harrislab-brown/particle_launcher/Launcher CAD & Fabrication Files/Version 6/For 1.5 mm Spheres/STEP Files/V6_Main-Tube-Section.step

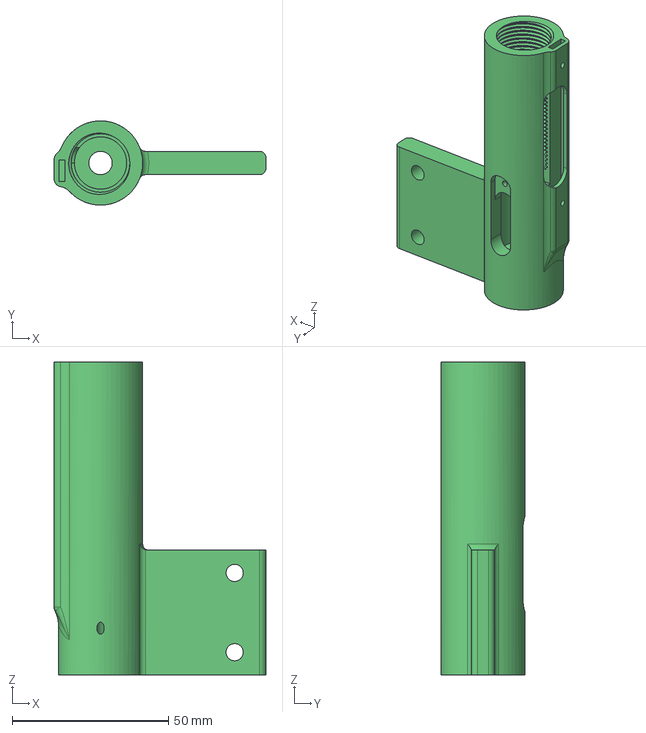
[picture p32: CAD file, 2026-04-17]
Launcher CAD & Fabrication Files/Version 6/For 1.5 mm Spheres/STEP Files/V6_Main-Tube-Section.step
67.8 x 27.0 x 100.3 mm
