harrislab-brown/particle_launcher/Launcher CAD & Fabrication Files/Version 6/For 1.5 mm Spheres/STEP Files/V6_Full-Assembly.step

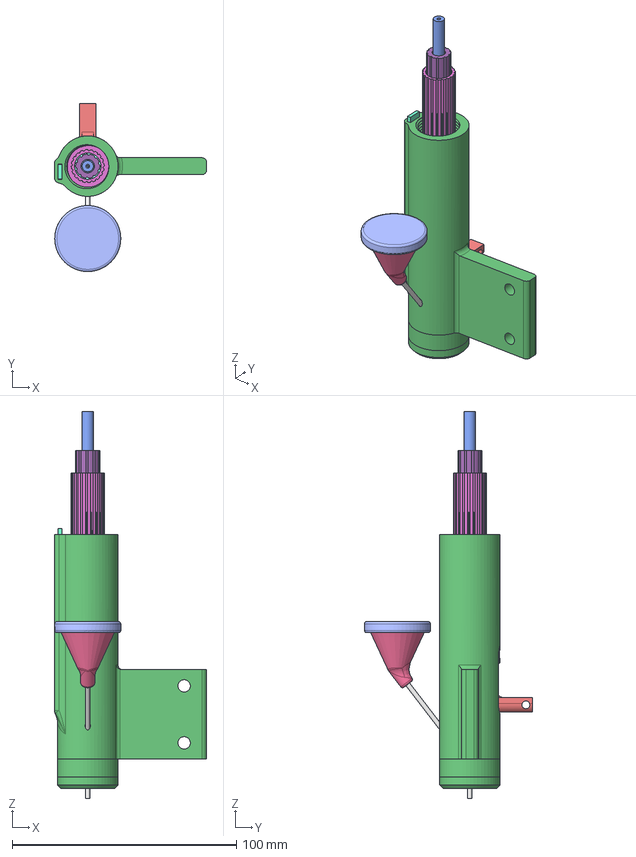
[picture p33: CAD file, 2026-04-17]
Launcher CAD & Fabrication Files/Version 6/For 1.5 mm Spheres/STEP Files/V6_Full-Assembly.step
67.8 x 75.0 x 172.5 mm
Barrel
Particle 1.5mm
Tube
Plunger Tip
Plunger
Latch
Collar
Adjust
Scale
Retainer
Guide
Backstop
Tool
Magazine
Funnel
Funnel Lid
