harrislab-brown/particle_launcher/Launcher CAD & Fabrication Files/Version 6/For 1.5 mm Spheres/3D Printing/PL Hypodermic Needle Cutting Jig.stl

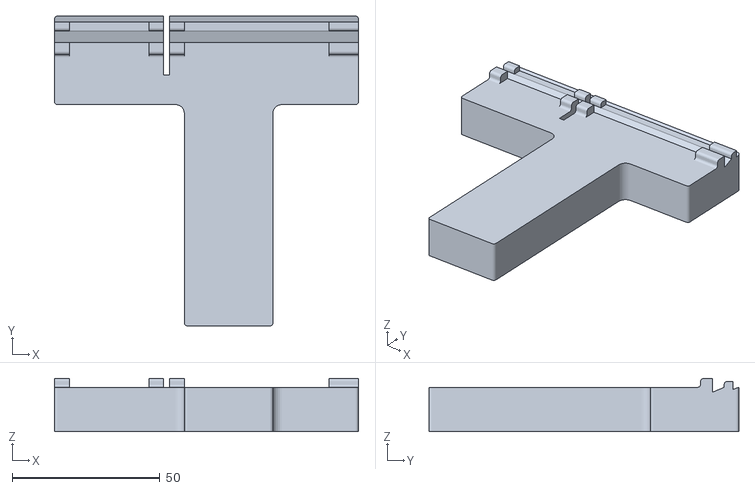
[picture p34: CAD file, 2026-04-17]
Launcher CAD & Fabrication Files/Version 6/For 1.5 mm Spheres/3D Printing/PL Hypodermic Needle Cutting Jig.stl
103.0 x 105.0 x 18.0
