harrislab-brown/particle_launcher/Launcher CAD & Fabrication Files/Version 6/For 1.5 mm Spheres/STEP Files/V6_Plunger-Tip.step

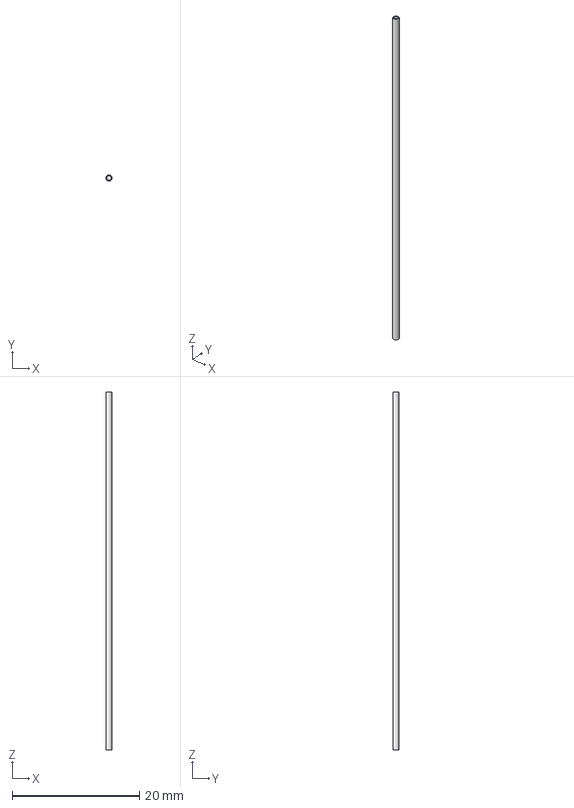
[picture p35: CAD file, 2026-04-17]
Launcher CAD & Fabrication Files/Version 6/For 1.5 mm Spheres/STEP Files/V6_Plunger-Tip.step
0.99 x 0.99 x 56.3 mm
