harrislab-brown/particle_launcher/Launcher CAD & Fabrication Files/Version 6/For 1 mm Spheres/3D Printing/Particle Launcher V6 1mm funnel.stl

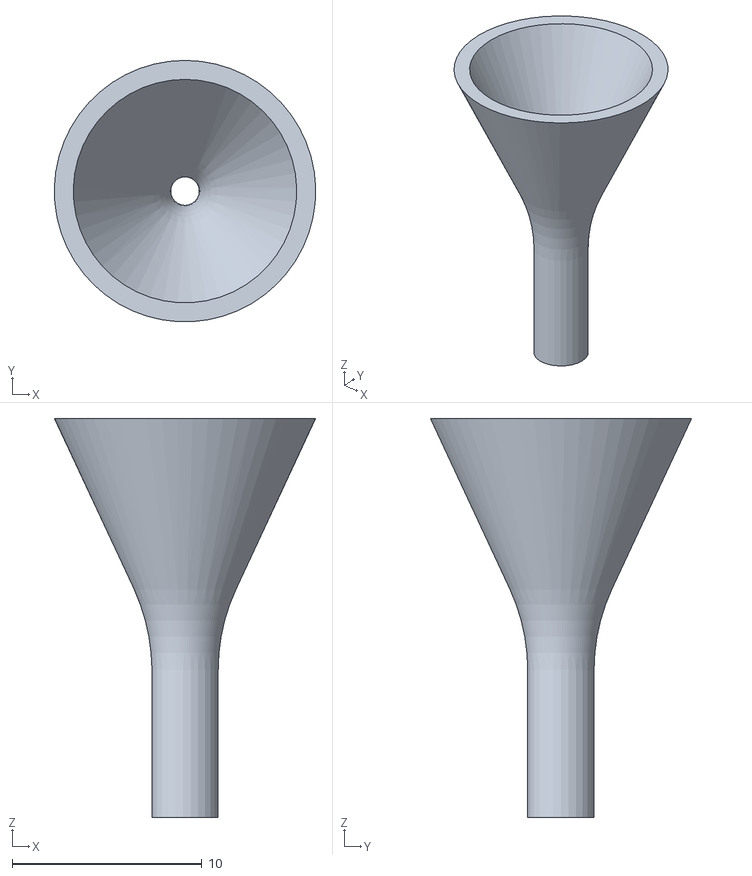
[picture p36: CAD file, 2026-05-19]
Launcher CAD & Fabrication Files/Version 6/For 1 mm Spheres/3D Printing/Particle Launcher V6 1mm funnel.stl
13.8 x 13.7 x 21.0
