harrislab-brown/particle_launcher/Launcher CAD & Fabrication Files/Version 6/For 1.5 mm Spheres/SOLIDWORKS/Tube_2.SLDPRT

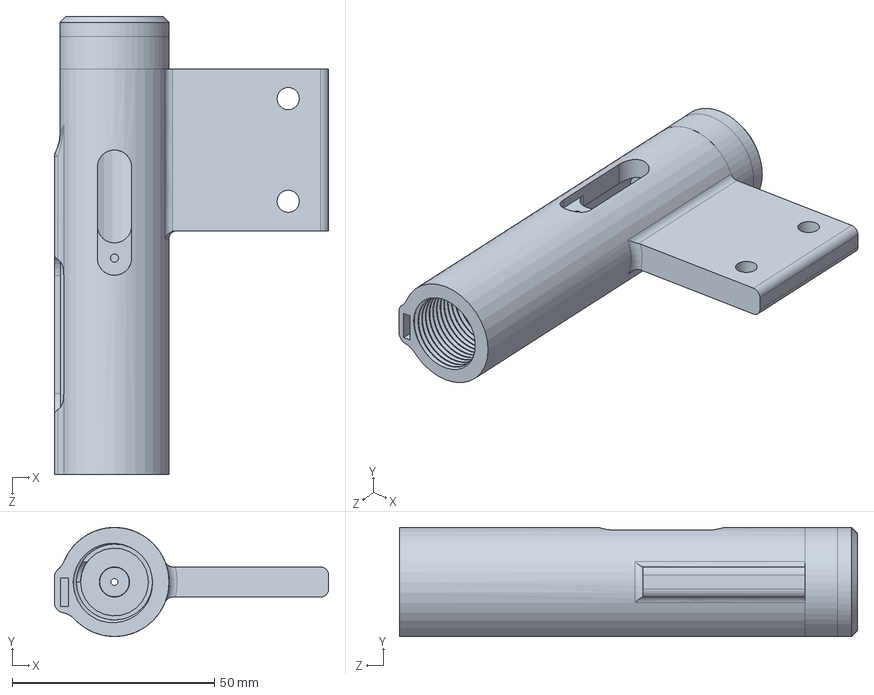
[picture p38: CAD file, 2026-04-17]
Launcher CAD & Fabrication Files/Version 6/For 1.5 mm Spheres/SOLIDWORKS/Tube_2.SLDPRT
67.8 x 27.0 x 113.3 mm
