harrislab-brown/particle_launcher/Launcher CAD & Fabrication Files/Version 6/For 1.5 mm Spheres/STEP Files/V6_Backstop-Tool.step

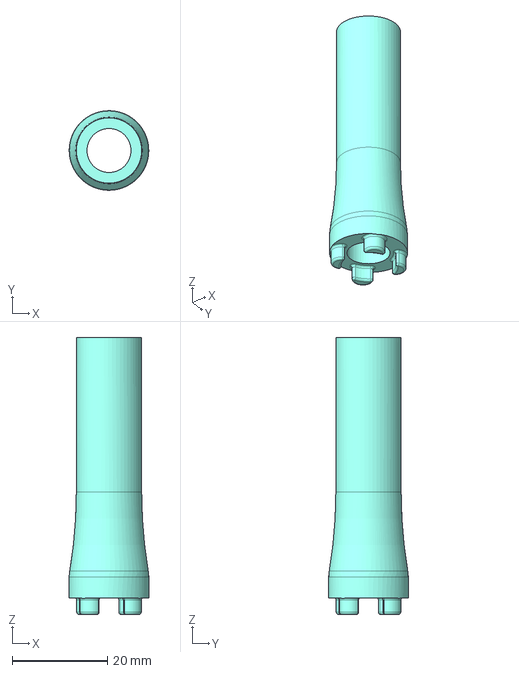
[picture p39: CAD file, 2026-04-17]
Launcher CAD & Fabrication Files/Version 6/For 1.5 mm Spheres/STEP Files/V6_Backstop-Tool.step
16.7 x 16.7 x 58.3 mm
