harrislab-brown/particle_launcher/Launcher CAD & Fabrication Files/Version 6/For 1 mm Spheres/3D Printing/Particle Launcher V6 1mm magazine.stl

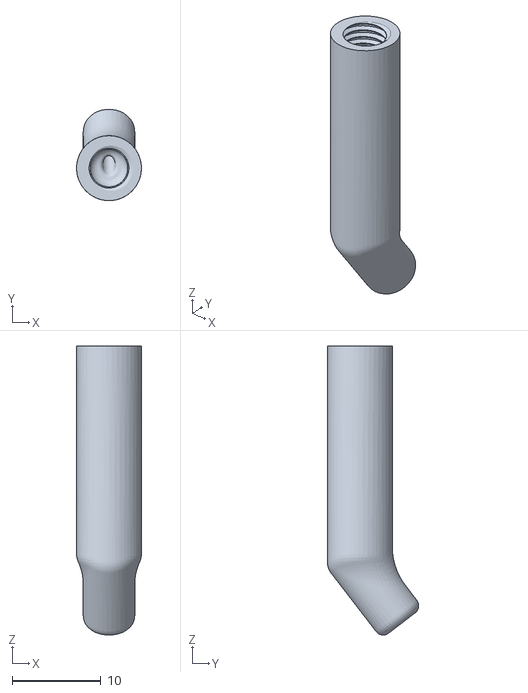
[picture p40: CAD file, 2026-05-19]
Launcher CAD & Fabrication Files/Version 6/For 1 mm Spheres/3D Printing/Particle Launcher V6 1mm magazine.stl
7.31 x 10.3 x 32.5
