harrislab-brown/particle_launcher/Launcher CAD & Fabrication Files/Version 6/For 1.5 mm Spheres/3D Printing/PL Hypodermic Needle Hole Sizer.stl

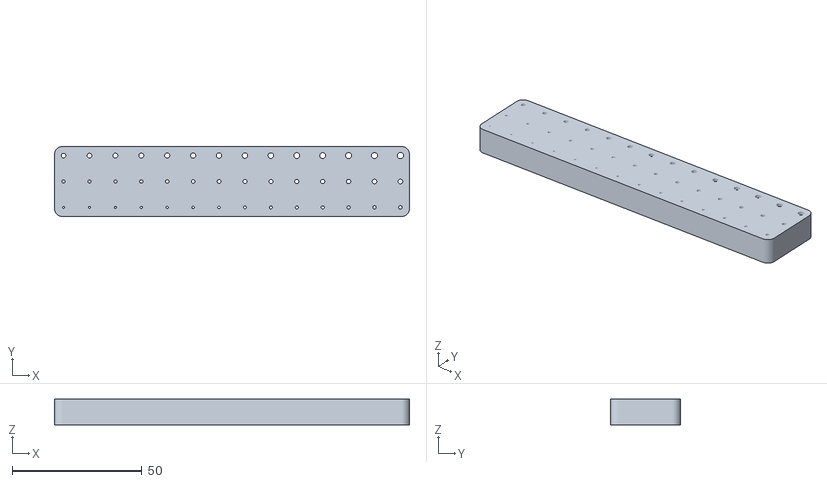
[picture p41: CAD file, 2026-04-17]
Launcher CAD & Fabrication Files/Version 6/For 1.5 mm Spheres/3D Printing/PL Hypodermic Needle Hole Sizer.stl
137.0 x 27.0 x 10.0
