harrislab-brown/particle_launcher/Launcher CAD & Fabrication Files/Version 6/For 1.5 mm Spheres/STEP Files/V6_Retainer.step

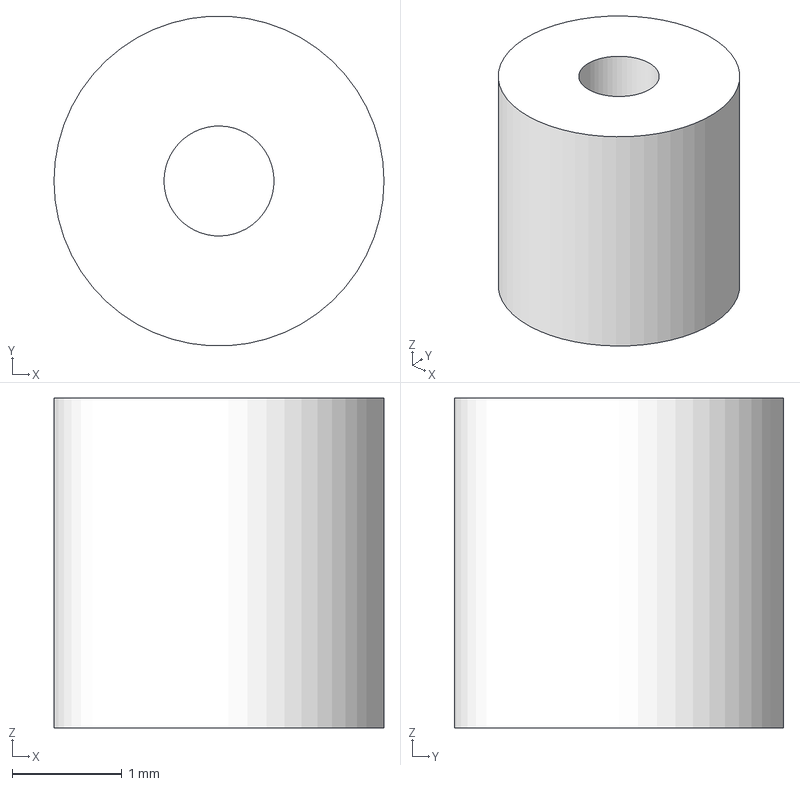
[picture p42: CAD file, 2026-04-17]
Launcher CAD & Fabrication Files/Version 6/For 1.5 mm Spheres/STEP Files/V6_Retainer.step
3.00 x 2.99 x 3.00 mm
