harrislab-brown/particle_launcher/Launcher CAD & Fabrication Files/Version 6/For 1 mm Spheres/3D Printing/Particle Launcher V6 1mm lid.stl

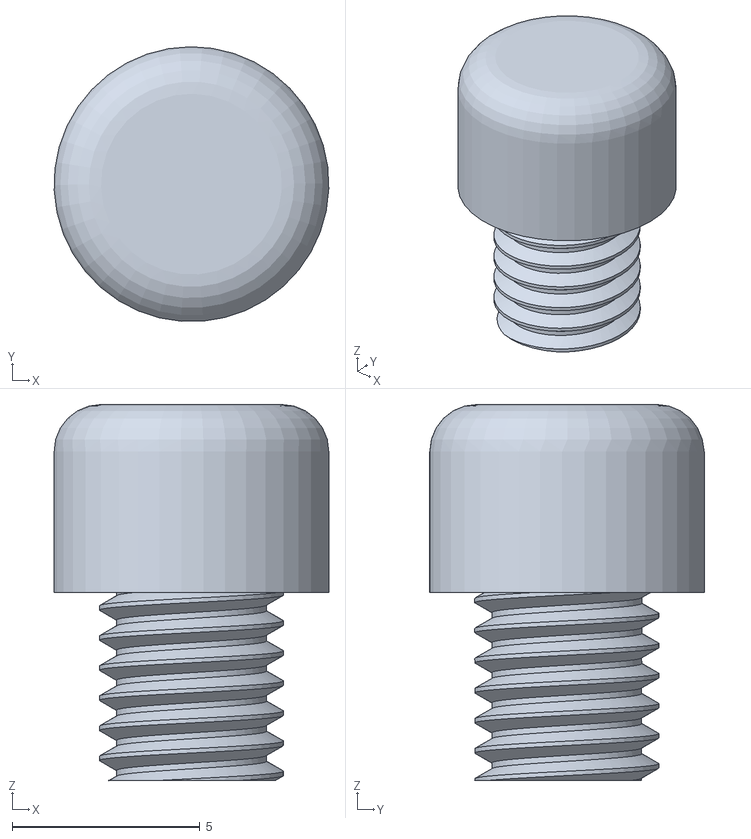
[picture p43: CAD file, 2026-05-19]
Launcher CAD & Fabrication Files/Version 6/For 1 mm Spheres/3D Printing/Particle Launcher V6 1mm lid.stl
7.30 x 7.30 x 10.0
