harrislab-brown/particle_launcher/Launcher CAD & Fabrication Files/Version 6/For 1 mm Spheres/3D Printing/Particle Launcher V6 1mm latch.stl

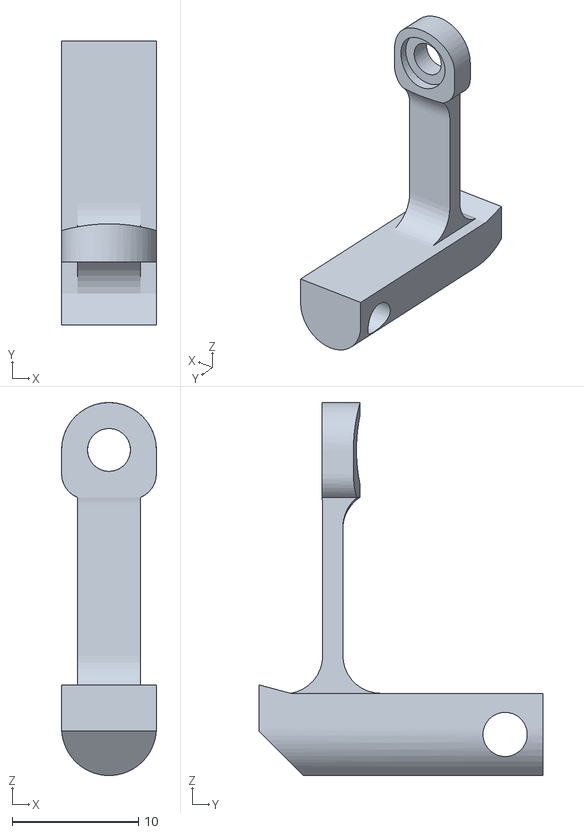
[picture p45: CAD file, 2026-05-19]
Launcher CAD & Fabrication Files/Version 6/For 1 mm Spheres/3D Printing/Particle Launcher V6 1mm latch.stl
7.50 x 22.5 x 29.5
