harrislab-brown/particle_launcher/Launcher CAD & Fabrication Files/Version 6/For 1.5 mm Spheres/3D Printing/Particle Launcher V6 plunger.stl

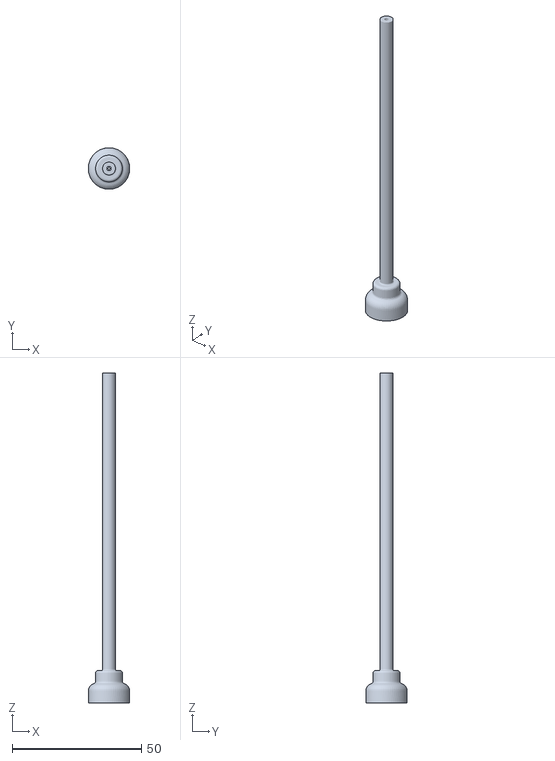
[picture p46: CAD file, 2026-04-17]
Launcher CAD & Fabrication Files/Version 6/For 1.5 mm Spheres/3D Printing/Particle Launcher V6 plunger.stl
16.0 x 16.0 x 127.5
