harrislab-brown/particle_launcher/Launcher CAD & Fabrication Files/Version 6/For 1 mm Spheres/3D Printing/Particle Launcher V6 1mm backstop.stl

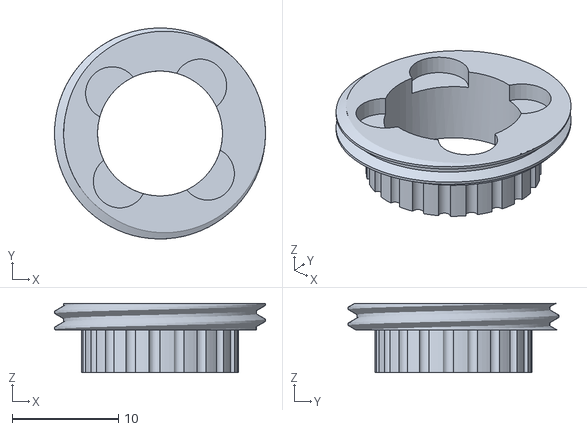
[picture p48: CAD file, 2026-05-19]
Launcher CAD & Fabrication Files/Version 6/For 1 mm Spheres/3D Printing/Particle Launcher V6 1mm backstop.stl
19.8 x 19.8 x 6.50
