harrislab-brown/particle_launcher/Launcher CAD & Fabrication Files/Version 6/For 1.5 mm Spheres/3D Printing/Particle Launcher V6 funnel.stl

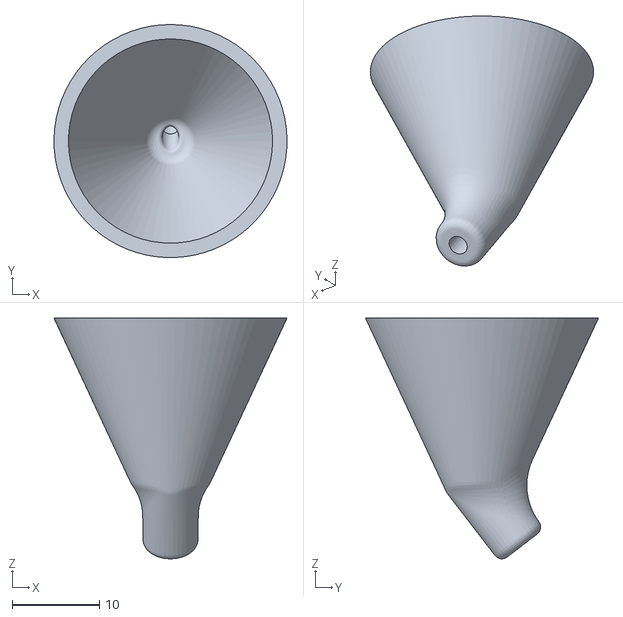
[picture p49: CAD file, 2026-04-17]
Launcher CAD & Fabrication Files/Version 6/For 1.5 mm Spheres/3D Printing/Particle Launcher V6 funnel.stl
26.7 x 26.6 x 27.5
