harrislab-brown/particle_launcher/Launcher CAD & Fabrication Files/Version 6/For 1.5 mm Spheres/3D Printing/Particle Launcher V6 funnel lid.stl

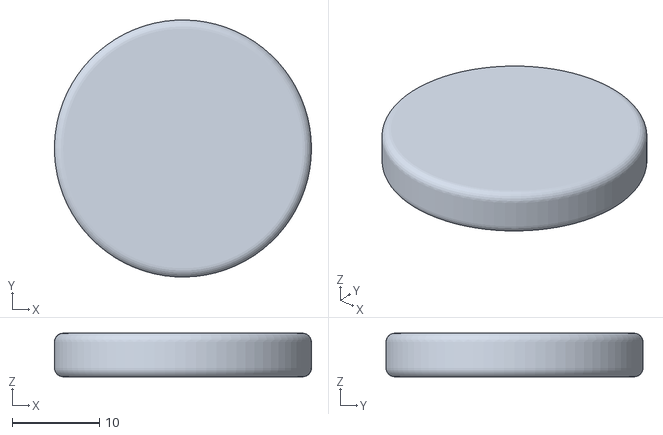
[picture p53: CAD file, 2026-04-17]
Launcher CAD & Fabrication Files/Version 6/For 1.5 mm Spheres/3D Printing/Particle Launcher V6 funnel lid.stl
29.4 x 29.5 x 5.00
