harrislab-brown/particle_launcher/Launcher CAD & Fabrication Files/Version 6/For 1.5 mm Spheres/SOLIDWORKS/Particle-Launcher-V6.SLDASM

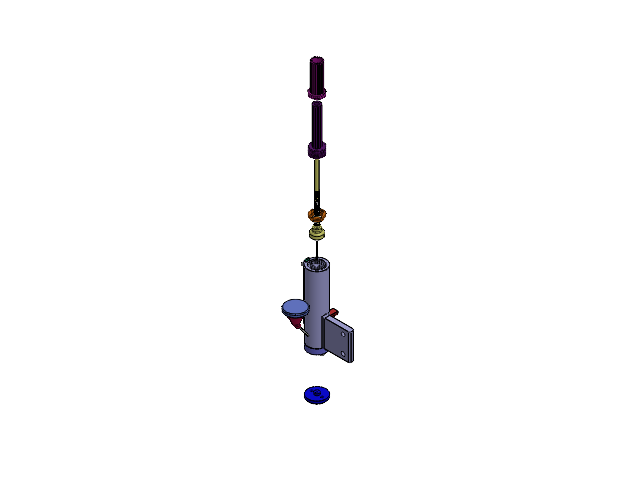
[picture p60: CAD file, 2026-04-17]
Launcher CAD & Fabrication Files/Version 6/For 1.5 mm Spheres/SOLIDWORKS/Particle-Launcher-V6.SLDASM
V6_Main-Tube-Section
V6_Middle-Tube-Section
V6_End-Tube-Section
V6_Adjust
V6_Backstop
V6_Barrel
V6_Collar
V6_Guide
V6_Latch
V6_Magazine
V6_Plunger-Tip
V6_Plunger
V6_Retainer
V6_Scale
V6_Funnel
V6_Funnel Lid
9657K42_Compression Spring
91292A015_18-8 Stainless Steel Socket Head Screw x 3
94459A140_Heat-Set Inserts for Plastic x 2
91292A115_18-8 Stainless Steel Socket Head Screw x 2
