harrislab-brown/particle_launcher/(list of files, cad)

Other CAD files:
Launcher CAD & Fabrication Files/Version 6/For 1 mm Spheres/3D Printing/PLV6_1mm_BAMBULABX1C.gcode.3mf
Launcher CAD & Fabrication Files/Version 6/For 1.5 mm Spheres/3D Printing/PLV6_1.5mm_BAMBULABX1C.gcode.3mf
Launcher CAD & Fabrication Files/Version 6/For 1.5 mm Spheres/SOLIDWORKS/Tool.SLDPRT
Launcher CAD & Fabrication Files/Version 6/For 1.5 mm Spheres/SOLIDWORKS/Particle 1.5mm.SLDPRT
Launcher CAD & Fabrication Files/Version 6/For 1.5 mm Spheres/STEP Files/V6_Plunger.step
Launcher CAD & Fabrication Files/Version 6/For 1.5 mm Spheres/3D Printing/Particle Launcher V6 backstop.stl
Launcher CAD & Fabrication Files/Version 6/For 1.5 mm Spheres/STEP Files/V6_Backstop.step
Launcher CAD & Fabrication Files/Version 6/For 1 mm Spheres/3D Printing/Particle Launcher V6 1mm tube.stl
Launcher CAD & Fabrication Files/Version 6/For 1.5 mm Spheres/3D Printing/Particle Launcher V6 latch.stl
Launcher CAD & Fabrication Files/Version 6/For 1.5 mm Spheres/3D Printing/Particle Launcher V6 tube.stl
Launcher CAD & Fabrication Files/Version 6/For 1.5 mm Spheres/STEP Files/V6_Funnel-Lid.step
Launcher CAD & Fabrication Files/Version 6/For 1.5 mm Spheres/3D Printing/Particle Launcher V6 tool.stl
Launcher CAD & Fabrication Files/Version 6/For 1 mm Spheres/3D Printing/Particle Launcher V6 1mm adjust.stl
Launcher CAD & Fabrication Files/Version 6/For 1.5 mm Spheres/3D Printing/Particle Launcher V6 middle.stl
Launcher CAD & Fabrication Files/Version 6/For 1.5 mm Spheres/3D Printing/Particle Launcher V6 end.stl
Launcher CAD & Fabrication Files/Version 6/For 1.5 mm Spheres/STEP Files/V6_Funnel.step
Launcher CAD & Fabrication Files/Version 6/For 1.5 mm Spheres/3D Printing/Particle Launcher V6 adjust.stl
Launcher CAD & Fabrication Files/Version 6/For 1.5 mm Spheres/STEP Files/V6_End-Tube-Section.step
Launcher CAD & Fabrication Files/Version 6/For 1.5 mm Spheres/3D Printing/Particle Launcher V6 collar.stl
Launcher CAD & Fabrication Files/Version 6/For 1.5 mm Spheres/STEP Files/V6_Collar.step
Launcher CAD & Fabrication Files/Version 6/For 1.5 mm Spheres/STEP Files/V6_Middle-Tube-Section.step
Launcher CAD & Fabrication Files/Tooling/PL Flex Tube Hole Sizer.f3d
Launcher CAD & Fabrication Files/Tooling/PL Hypodermic Needle Cutting Jig.f3d
Launcher CAD & Fabrication Files/Tooling/PL Hypodermic Needle Hole Sizer.f3d
Launcher CAD & Fabrication Files/Tooling/PL Mirror Bracket.f3d
Launcher CAD & Fabrication Files/Version 6/For 1 mm Spheres/Fusion/Particle Launcher V6 1mm.f3d
Launcher CAD & Fabrication Files/Version 6/For 1.5 mm Spheres/Fusion/Particle Launcher V6.f3d
Launcher CAD & Fabrication Files/Version 6/For 1.5 mm Spheres/SOLIDWORKS/91292A015_18-8 Stainless Steel Socket Head Screw.SLDPRT
Launcher CAD & Fabrication Files/Version 6/For 1.5 mm Spheres/SOLIDWORKS/91292A115_18-8 Stainless Steel Socket Head Screw.SLDPRT
Launcher CAD & Fabrication Files/Version 6/For 1.5 mm Spheres/SOLIDWORKS/94459A140_Heat-Set Inserts for Plastic.SLDPRT
Launcher CAD & Fabrication Files/Version 6/For 1.5 mm Spheres/SOLIDWORKS/9657K42_Compression Spring.SLDPRT
Launcher CAD & Fabrication Files/Version 6/For 1.5 mm Spheres/SOLIDWORKS/Drawings/Particle-Launcher-V6.SLDDRW
Launcher CAD & Fabrication Files/Version 6/For 1.5 mm Spheres/SOLIDWORKS/Drawings/V6_Adjust.SLDDRW
Launcher CAD & Fabrication Files/Version 6/For 1.5 mm Spheres/SOLIDWORKS/Drawings/V6_Backstop.SLDDRW
Launcher CAD & Fabrication Files/Version 6/For 1.5 mm Spheres/SOLIDWORKS/Drawings/V6_Barrel.SLDDRW
Launcher CAD & Fabrication Files/Version 6/For 1.5 mm Spheres/SOLIDWORKS/Drawings/V6_Collar.SLDDRW
Launcher CAD & Fabrication Files/Version 6/For 1.5 mm Spheres/SOLIDWORKS/Drawings/V6_End-Tube-Section.SLDDRW
Launcher CAD & Fabrication Files/Version 6/For 1.5 mm Spheres/SOLIDWORKS/Drawings/V6_Funnel Lid.SLDDRW
Launcher CAD & Fabrication Files/Version 6/For 1.5 mm Spheres/SOLIDWORKS/Drawings/V6_Funnel.SLDDRW
Launcher CAD & Fabrication Files/Version 6/For 1.5 mm Spheres/SOLIDWORKS/Drawings/V6_Guide.SLDDRW
Launcher CAD & Fabrication Files/Version 6/For 1.5 mm Spheres/SOLIDWORKS/Drawings/V6_Latch.SLDDRW
Launcher CAD & Fabrication Files/Version 6/For 1.5 mm Spheres/SOLIDWORKS/Drawings/V6_Magazine.SLDDRW
Launcher CAD & Fabrication Files/Version 6/For 1.5 mm Spheres/SOLIDWORKS/Drawings/V6_Main-Tube-Section.SLDDRW
Launcher CAD & Fabrication Files/Version 6/For 1.5 mm Spheres/SOLIDWORKS/Drawings/V6_Middle-Tube-Section.SLDDRW
Launcher CAD & Fabrication Files/Version 6/For 1.5 mm Spheres/SOLIDWORKS/Drawings/V6_Plunger-Tip.SLDDRW
Launcher CAD & Fabrication Files/Version 6/For 1.5 mm Spheres/SOLIDWORKS/Drawings/V6_Plunger.SLDDRW
Launcher CAD & Fabrication Files/Version 6/For 1.5 mm Spheres/SOLIDWORKS/Drawings/V6_Retainer.SLDDRW
Launcher CAD & Fabrication Files/Version 6/For 1.5 mm Spheres/SOLIDWORKS/Drawings/V6_Scale.SLDDRW
Launcher CAD & Fabrication Files/Version 6/For 1.5 mm Spheres/SOLIDWORKS/V6_Adjust.SLDPRT
Launcher CAD & Fabrication Files/Version 6/For 1.5 mm Spheres/SOLIDWORKS/V6_Backstop.SLDPRT
Launcher CAD & Fabrication Files/Version 6/For 1.5 mm Spheres/SOLIDWORKS/V6_Barrel.SLDPRT
Launcher CAD & Fabrication Files/Version 6/For 1.5 mm Spheres/SOLIDWORKS/V6_Collar.SLDPRT
Launcher CAD & Fabrication Files/Version 6/For 1.5 mm Spheres/SOLIDWORKS/V6_End-Tube-Section.SLDPRT
Launcher CAD & Fabrication Files/Version 6/For 1.5 mm Spheres/SOLIDWORKS/V6_Full-Assembly(2).SLDASM
Launcher CAD & Fabrication Files/Version 6/For 1.5 mm Spheres/SOLIDWORKS/V6_Full-Assembly.SLDASM
Launcher CAD & Fabrication Files/Version 6/For 1.5 mm Spheres/SOLIDWORKS/V6_Funnel Lid.SLDPRT
Launcher CAD & Fabrication Files/Version 6/For 1.5 mm Spheres/SOLIDWORKS/V6_Funnel.SLDPRT
Launcher CAD & Fabrication Files/Version 6/For 1.5 mm Spheres/SOLIDWORKS/V6_Guide.SLDPRT
Launcher CAD & Fabrication Files/Version 6/For 1.5 mm Spheres/SOLIDWORKS/V6_Latch.SLDPRT
Launcher CAD & Fabrication Files/Version 6/For 1.5 mm Spheres/SOLIDWORKS/V6_Magazine.SLDPRT
Launcher CAD & Fabrication Files/Version 6/For 1.5 mm Spheres/SOLIDWORKS/V6_Main-Tube-Section.SLDPRT
Launcher CAD & Fabrication Files/Version 6/For 1.5 mm Spheres/SOLIDWORKS/V6_Middle-Tube-Section.SLDPRT
Launcher CAD & Fabrication Files/Version 6/For 1.5 mm Spheres/SOLIDWORKS/V6_Plunger-Tip.SLDPRT
Launcher CAD & Fabrication Files/Version 6/For 1.5 mm Spheres/SOLIDWORKS/V6_Plunger.SLDPRT
Launcher CAD & Fabrication Files/Version 6/For 1.5 mm Spheres/SOLIDWORKS/V6_Retainer.SLDPRT
Launcher CAD & Fabrication Files/Version 6/For 1.5 mm Spheres/SOLIDWORKS/V6_Scale.SLDPRT
Launcher CAD & Fabrication Files/Versions 1-5/Particle Launcher V1.f3d
Launcher CAD & Fabrication Files/Versions 1-5/Particle Launcher V2-V3.f3d
Launcher CAD & Fabrication Files/Versions 1-5/Particle Launcher V4.f3d
Launcher CAD & Fabrication Files/Versions 1-5/Particle Launcher V5.5 1mm.f3d
Launcher CAD & Fabrication Files/Versions 1-5/Particle Launcher V5.f3d
