harrislab-brown/particle_launcher/Launcher CAD & Fabrication Files/Version 6/For 1.5 mm Spheres/SOLIDWORKS/AssemPic.png

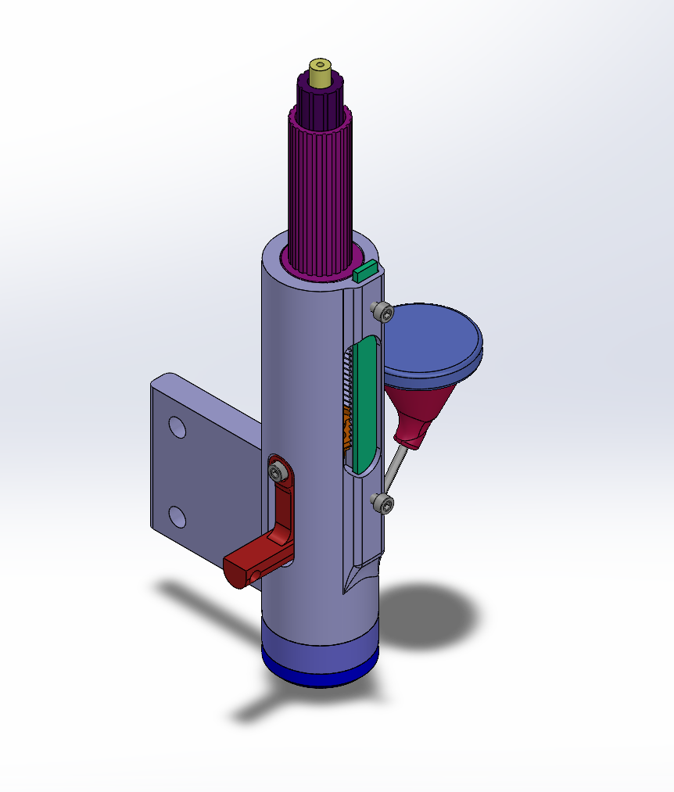
Launcher CAD & Fabrication Files/Version 6/For 1.5 mm Spheres/SOLIDWORKS/AssemPic.png
