harrislab-brown/particle_launcher/Launcher CAD & Fabrication Files/Version 6/For 1.5 mm Spheres/SOLIDWORKS/Drawings/Particle-Launcher-V6_sheet2 copy.PNG

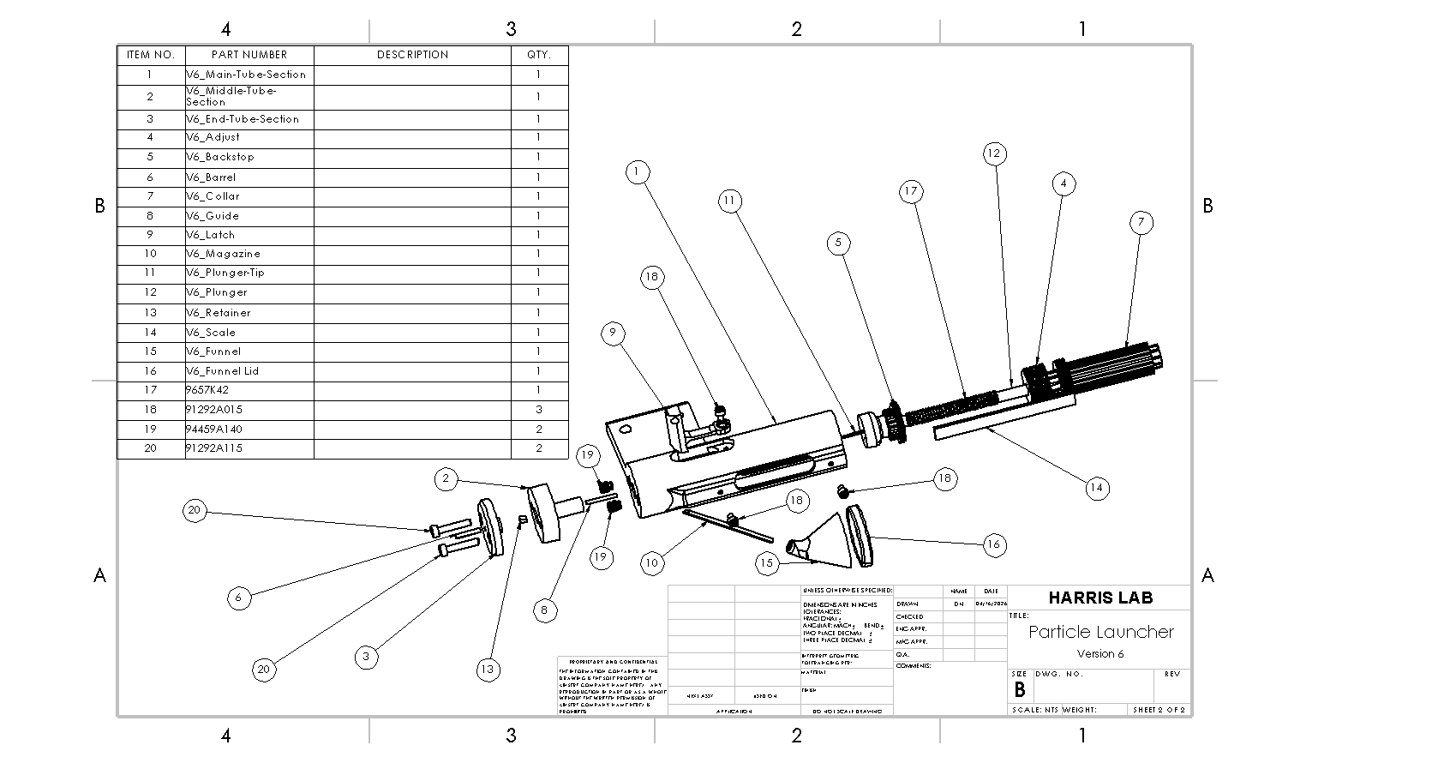
Launcher CAD & Fabrication Files/Version 6/For 1.5 mm Spheres/SOLIDWORKS/Drawings/Particle-Launcher-V6_sheet2 copy.PNG
