harrislab-brown/particle_launcher/sphere_tracking/scrapped sphere tracking/sphere_results.csv

-0.00017446992997189 | -0.0316304365709858 | 1.12473963070912e-05
-0.00017957161328979 | -0.0308132365032768 | 1.3789979136524e-05
-0.000184409683682624 | -0.0291788363678586 | 1.62013040457478e-05
-0.00018898414115039 | -0.0275444362324403 | 1.84813710347628e-05
-0.000193294985693089 | -0.0259100360970219 | 2.0630180103569e-05
-0.00019734221731072 | -0.0242756359616035 | 2.26477312521662e-05
-0.000201125836003283 | -0.0226412358261853 | 2.45340244805545e-05
-0.000204645841770779 | -0.021006835690767 | 2.6289059788734e-05
-0.000207902234613208 | -0.0193724355553486 | 2.79128371767046e-05
-0.000210895014530569 | -0.0177380354199302 | 2.94053566444664e-05
-0.000213624181522863 | -0.0161036352845119 | 3.07666181920192e-05
-0.000216089735590089 | -0.0144692351490935 | 3.19966218193632e-05
-0.000218291676732248 | -0.0128348350136753 | 3.30953675264983e-05
-0.000220230004949339 | -0.011200434878257 | 3.40628553134245e-05
-0.000221904720241363 | -0.00956603474283858 | 3.48990851801418e-05
-0.00022331582260832 | 0.00346403497770069 | 3.56040571266503e-05
-0.000220787289603395 | 0.0113501783301554 | 3.547947402811e-05
-0.000219654474759882 | 0.00336657978489084 | 3.52771973243086e-05
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
