harrislab-brown/particle_launcher/Launcher CAD & Fabrication Files/Version 6/For 1.5 mm Spheres/SOLIDWORKS/Drawings/Particle-Launcher-V6.pdf

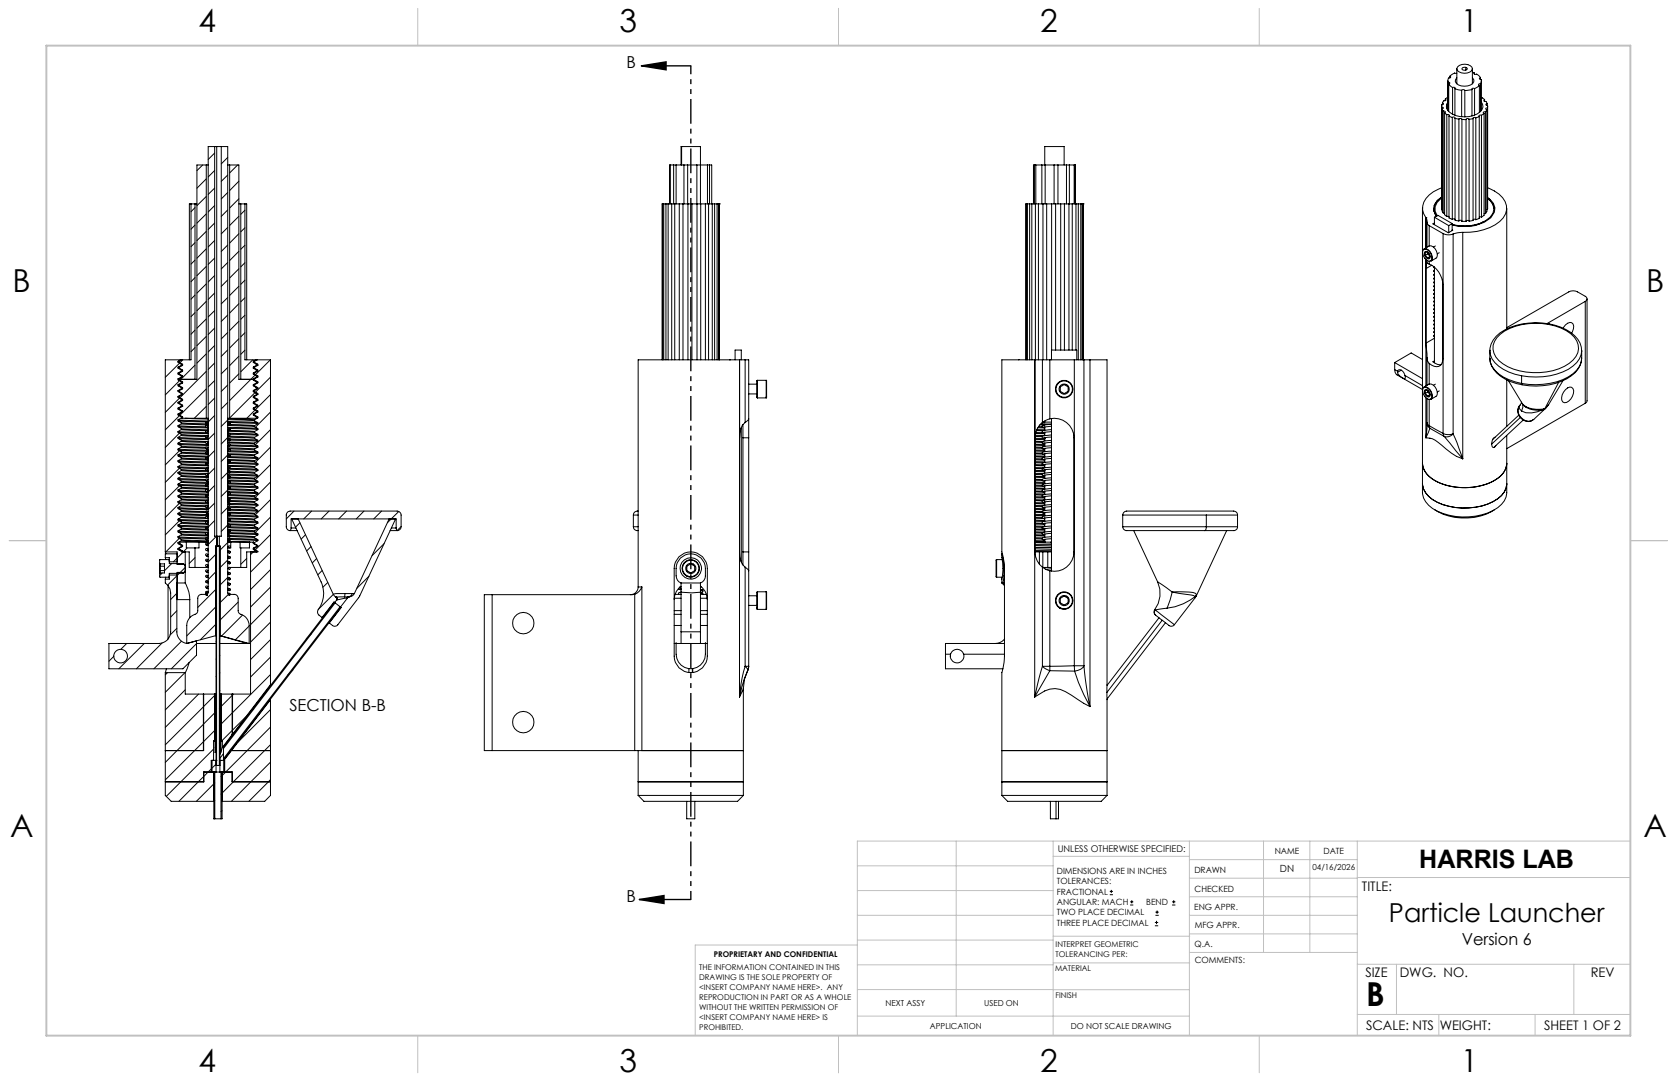
[picture p81: page 1]
SECTION B-B

UNLESS OTHERWISE SPECIFIED: | | | DATE | HARRIS LAB NAME
DIMENSIONS ARE IN INCHES TOLERANCES: FRACTIONAL ANGULAR: MACH BEND TWO PLACE DECIMAL THREE PLACE DECIMAL | DRAWN | DN | 04/16/2026

CHECKED | | | TITLE: Particle Launcher Version 6

ENG APPR.
MFG APPR.

INTERPRET GEOMETRIC TOLERANCING PER: | Q.A.
MATERIAL | | SIZE B | DWG. NO. | REV

PROPRIETARY AND CONFIDENTIAL
THE INFORMATION CONTAINED IN THIS
DRAWING IS THE SOLE PROPERTY OF
<INSERT COMPANY NAME HERE>. ANY
REPRODUCTION IN PART OR AS A WHOLE
WITHOUT THE WRITTEN PERMISSION OF
<INSERT COMPANY NAME HERE> IS
PROHIBITED.

NEXT ASSY | USED ON | FINISH

APPLICATION | DO NOT SCALE DRAWING | | SCALE: NTS | WEIGHT: | SHEET 1 OF 2

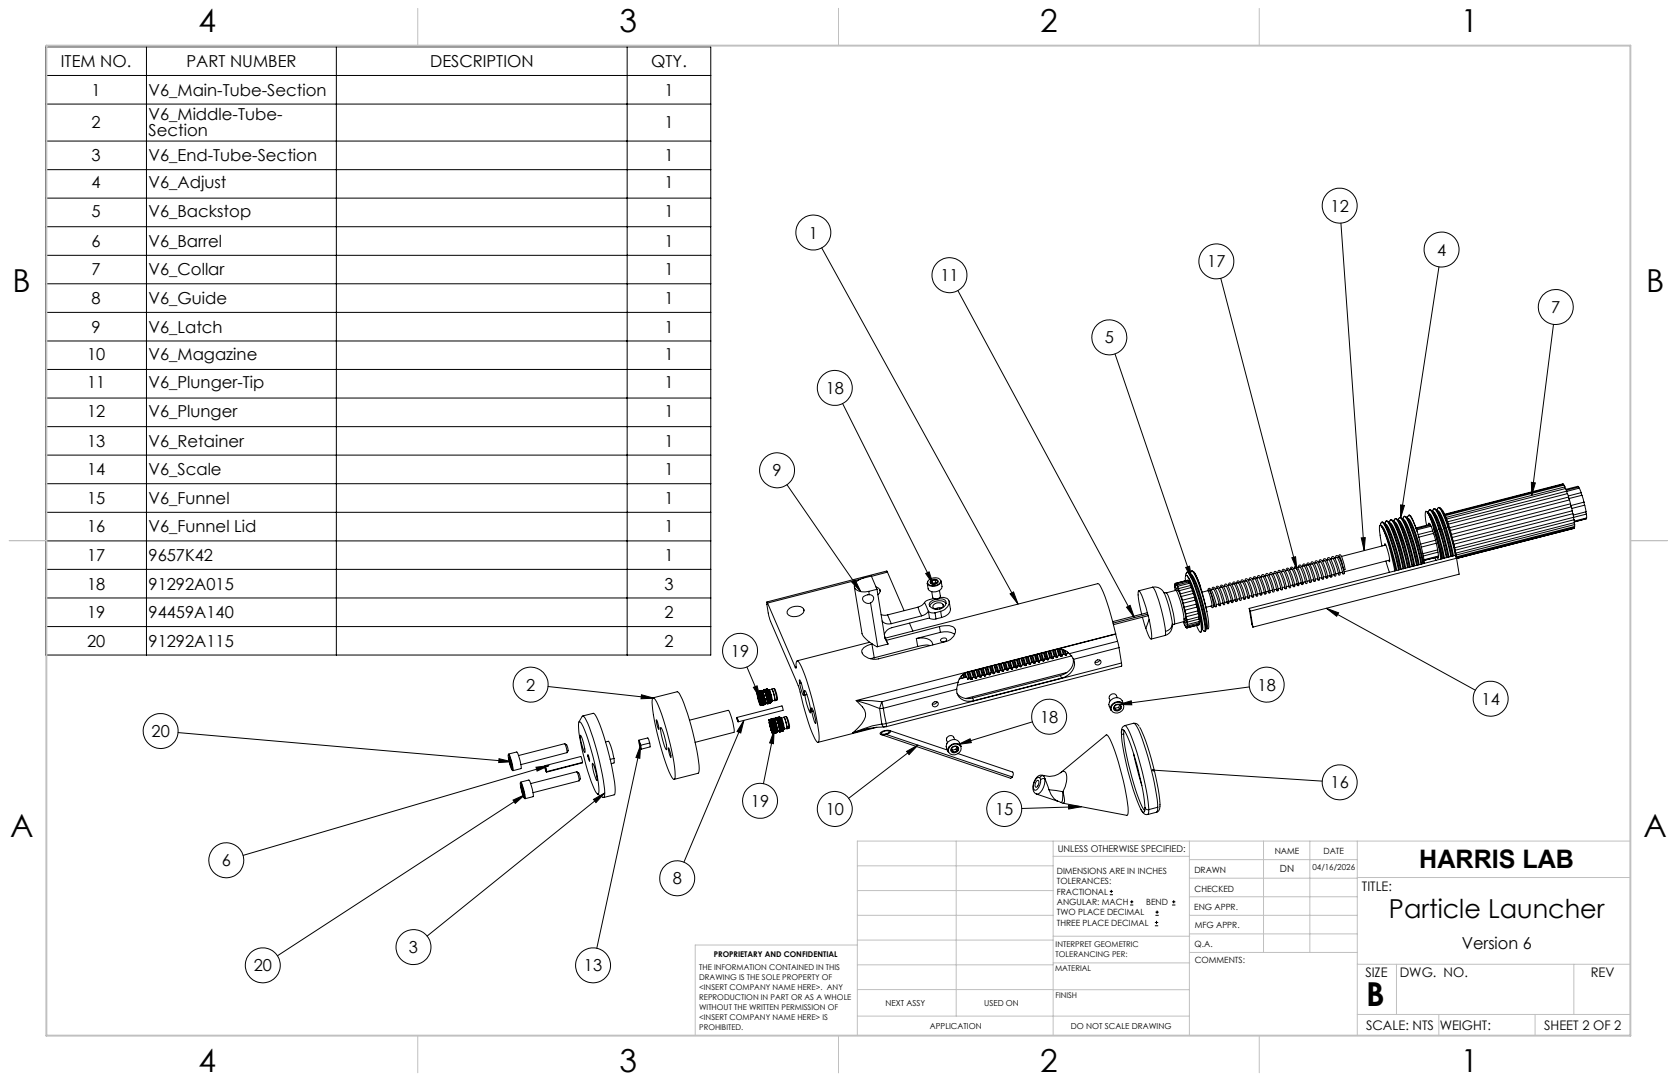
[picture p82: page 2]

ITEM NO. | PART NUMBER | DESCRIPTION | QTY.
1 | V6_Main-Tube-Section | | 1
2 | V6_Middle-Tube-Section | | 1
3 | V6_End-Tube-Section | | 1
4 | V6_Adjust | | 1
5 | V6_Backstop | | 1
6 | V6_Barrel | | 1
7 | V6_Collar | | 1
8 | V6_Guide | | 1
9 | V6_Latch | | 1
10 | V6_Magazine | | 1
11 | V6_Plunger-Tip | | 1
12 | V6_Plunger | | 1
13 | V6_Retainer | | 1
14 | V6_Scale | | 1
15 | V6_Funnel | | 1
16 17 | V6_Funnel Lid 9657K42 | | 1 1

18 | 91292A015 | | 3
19 | 94459A140 | | 2
20 | 91292A115 | | 2

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

CHECKED | | | TITLE: Particle Launcher Version 6

ENG APPR.
MFG APPR.

INTERPRET GEOMETRIC TOLERANCING PER: | Q.A.
MATERIAL | | SIZE B | DWG. NO. | REV

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

NEXT ASSY | USED ON | FINISH

APPLICATION | DO NOT SCALE DRAWING | | SCALE: NTS | WEIGHT: | SHEET 2 OF 2
