harrislab-brown/particle_launcher/Launcher CAD & Fabrication Files/Version 6/For 1.5 mm Spheres/SOLIDWORKS/Drawings/V6_Adjust.pdf

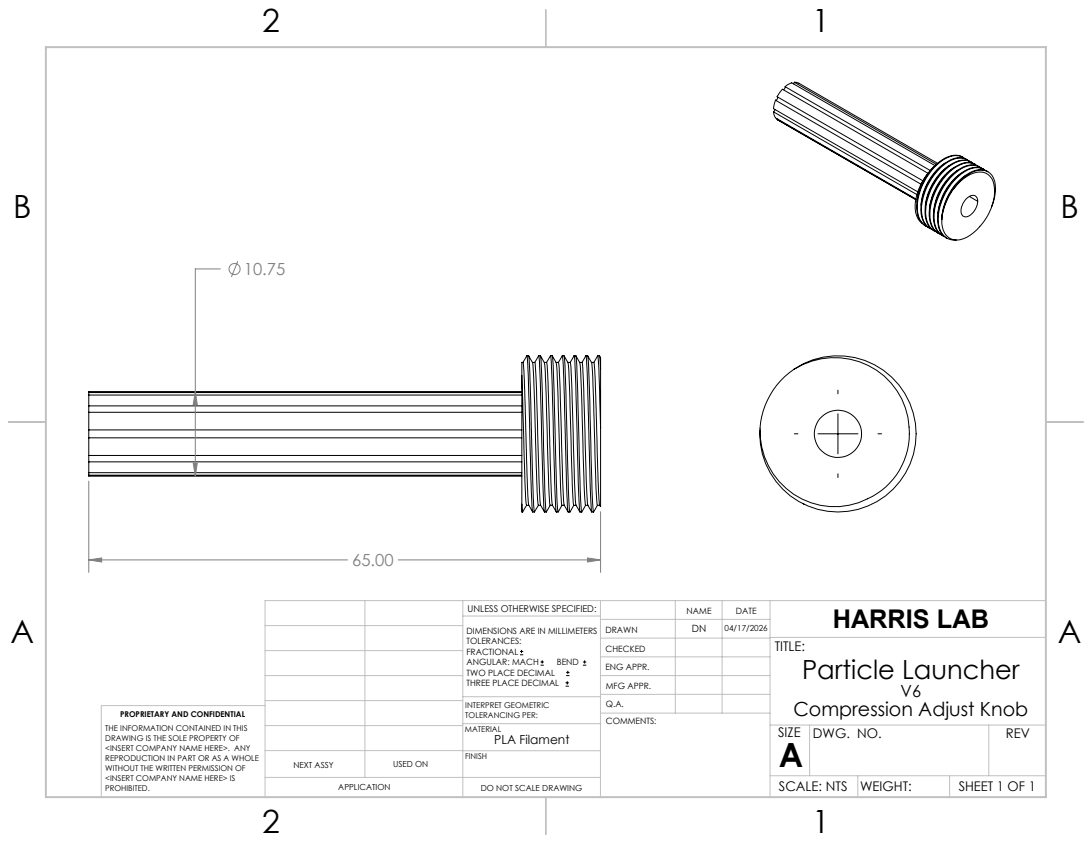
[picture p83: page 1]

UNLESS OTHERWISE SPECIFIED: | | | DATE | HARRIS LAB NAME

DIMENSIONS ARE IN MILLIMETERS TOLERANCES: FRACTIONAL ANGULAR: MACH BEND TWO PLACE DECIMAL THREE PLACE DECIMAL | DRAWN | DN | 04/17/2026

CHECKED | | | TITLE: Particle Launcher V6 Compression Adjust Knob

ENG APPR.
MFG APPR.

INTERPRET GEOMETRIC TOLERANCING PER: | Q.A.
MATERIAL PLA Filament | | SIZE A | DWG. NO. | REV

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

NEXT ASSY | USED ON | FINISH

APPLICATION | DO NOT SCALE DRAWING | | SCALE: NTS | WEIGHT: | SHEET 1 OF 1
