harrislab-brown/particle_launcher/Launcher CAD & Fabrication Files/Version 6/For 1.5 mm Spheres/SOLIDWORKS/Drawings/V6_Guide.pdf

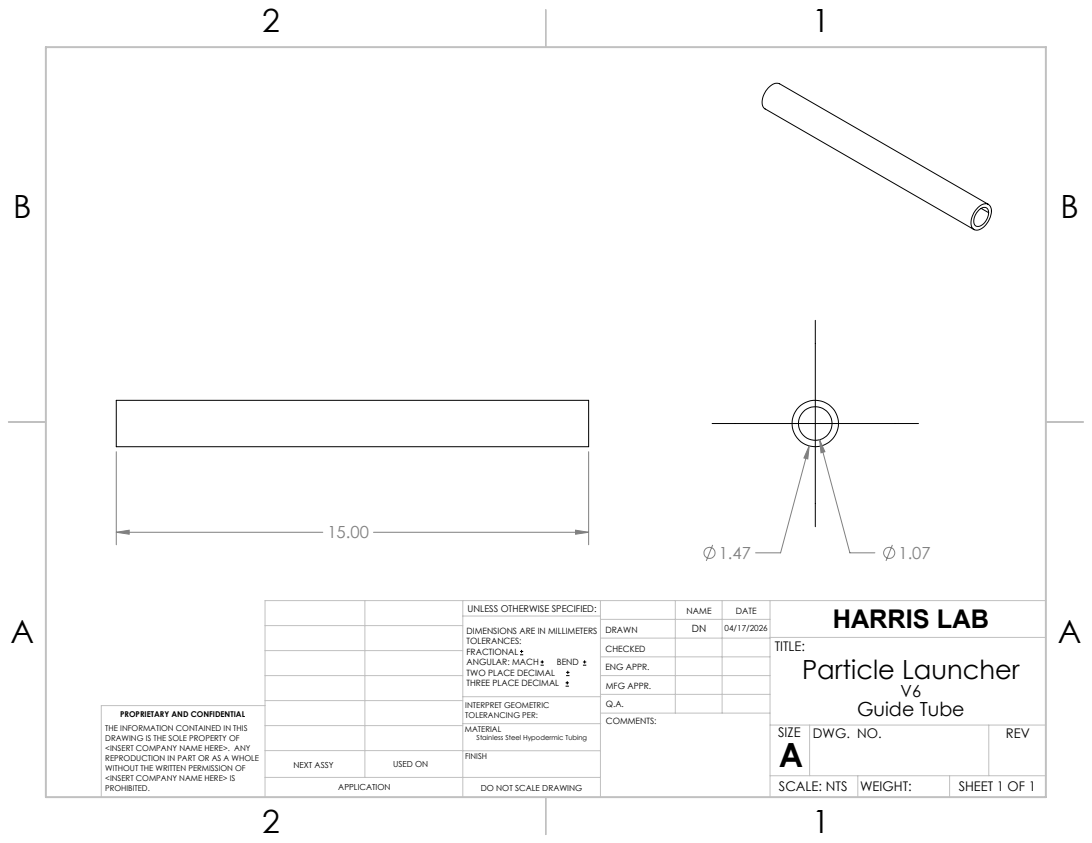
[picture p84: page 1]

UNLESS OTHERWISE SPECIFIED: | | | DATE | HARRIS LAB NAME

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

CHECKED | | | TITLE: Particle Launcher V6 Guide Tube

ENG APPR.
MFG APPR.

INTERPRET GEOMETRIC TOLERANCING PER: | Q.A.

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

MATERIAL Stainless Steel Hypodermic Tubing | | SIZE A | DWG. NO. | REV

NEXT ASSY | USED ON | FINISH

APPLICATION | DO NOT SCALE DRAWING | | SCALE: NTS | WEIGHT: | SHEET 1 OF 1
