harrislab-brown/particle_launcher/mega_shield/Launcher_PCB/Launcher_PCB.kicad_pcb

## KiCad design mega_shield/Launcher_PCB/Launcher_PCB.kicad_pcb (2026-03-05)

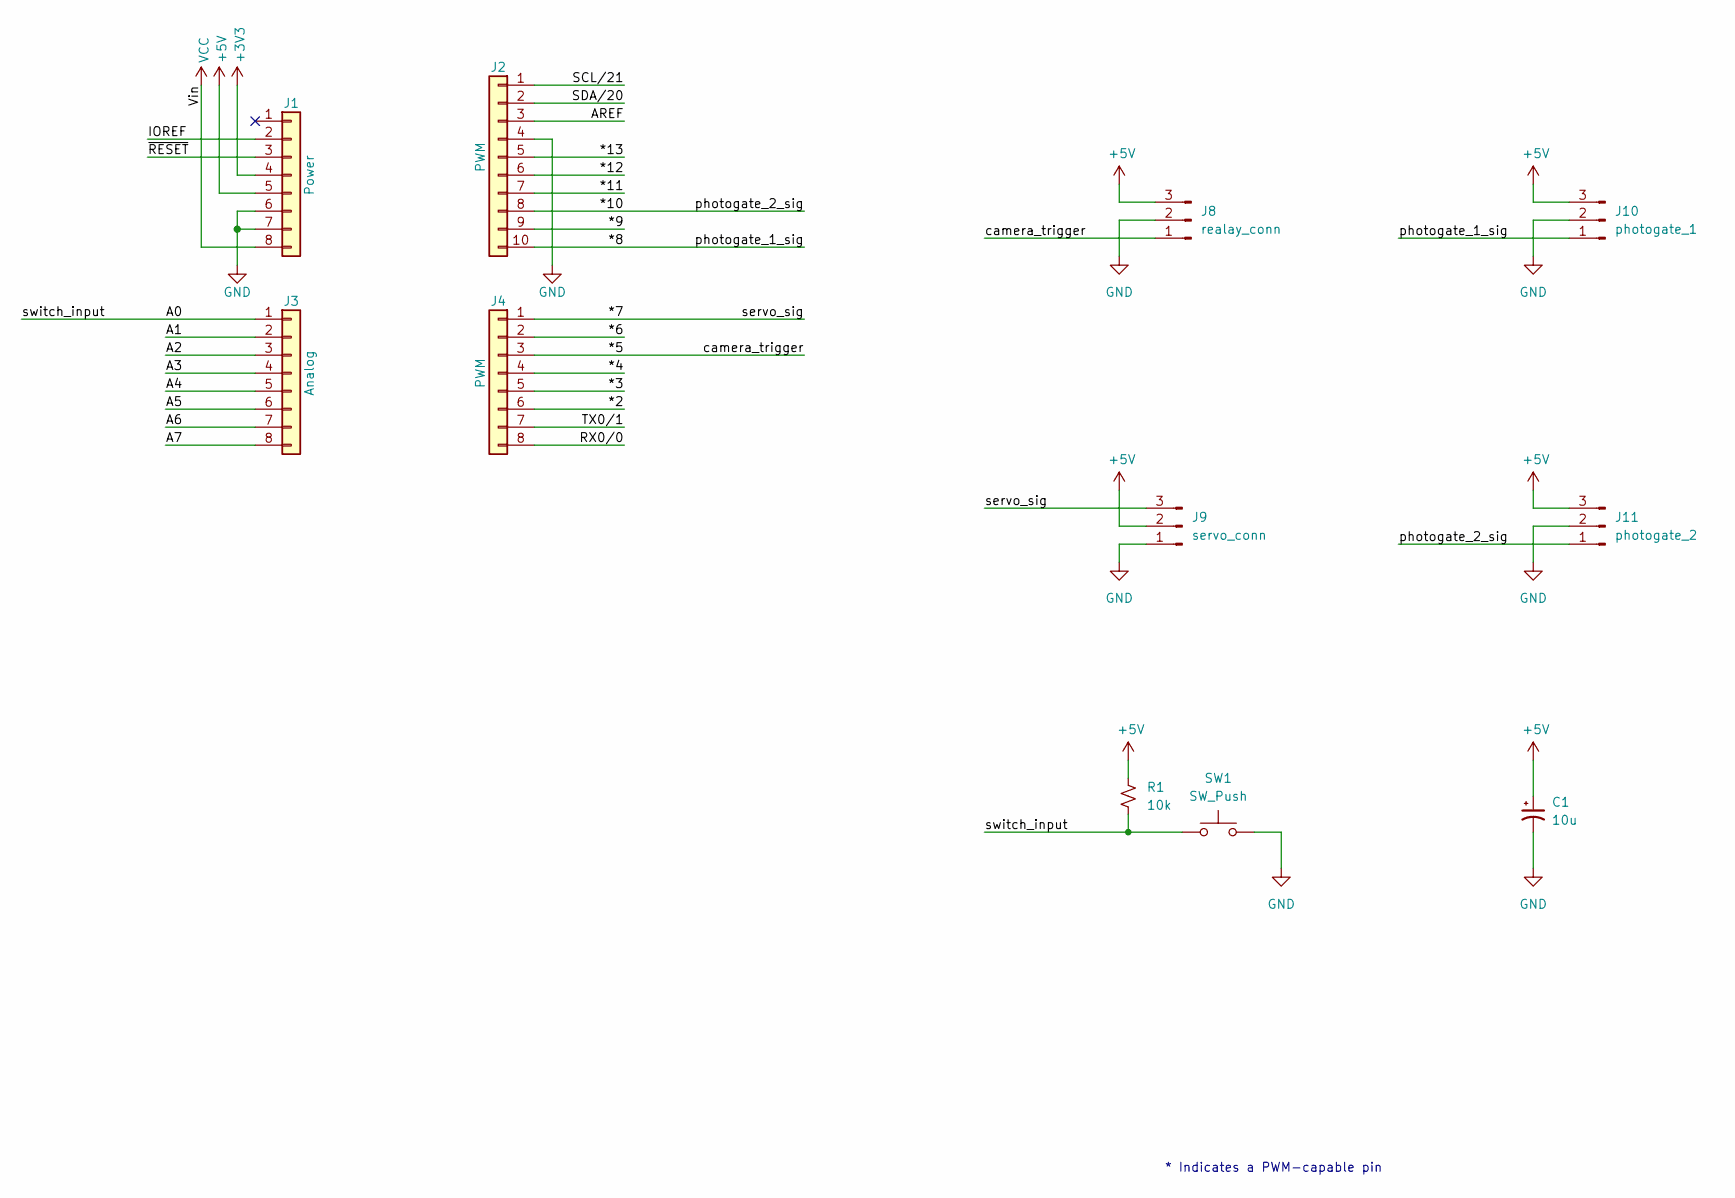
[picture p85: schematic Launcher_PCB.kicad_sch]

Parts:
C1: 10u; CP_Elec_5x5.4
J1: Power; PinHeader_1x08_P2.54mm_Vertical
J2: PWM; PinSocket_1x10_P2.54mm_Vertical
J3: Analog; PinSocket_1x08_P2.54mm_Vertical
J4: PWM; PinSocket_1x08_P2.54mm_Vertical
J8: realay_conn; PinHeader_1x03_P2.54mm_Vertical_SMD_Pin1Left
J9: servo_conn; PinHeader_1x03_P2.54mm_Vertical_SMD_Pin1Left
J10: photogate_1; PinHeader_1x03_P2.54mm_Vertical_SMD_Pin1Left
J11: photogate_2; PinHeader_1x03_P2.54mm_Vertical_SMD_Pin1Left
R1: 10k; R_0603_1608Metric_Pad0.98x0.95mm_HandSolder
SW1: SW_Push; SW_PUSH_6mm

Connections:
+3V3: J1.4
+5V: C1.1, J1.5, J8.3, J9.2, J10.3, J11.3, R1.1
/*2: J4.6
/*3: J4.5
/*4: J4.4
/*5: J4.3, J8.1
/*6: J4.2
/*7: J4.1, J9.3
/*8: J2.10, J10.1
/*9: J2.9
/*10: J2.8, J11.1
/*11: J2.7
/*12: J2.6
/*13: J2.5
/A0: J3.1, R1.2, SW1.1
/A1: J3.2
/A2: J3.3
/A3: J3.4
/A4: J3.5
/A5: J3.6
/A6: J3.7
/A7: J3.8
/AREF: J2.3
/IOREF: J1.2
/RX0/0: J4.8
/SCL/21: J2.1
/SDA/20: J2.2
/TX0/1: J4.7
/~RESET: J1.3
GND: C1.2, J1.6, J1.7, J2.4, J8.2, J9.1, J10.2, J11.2, SW1.2
VCC: J1.8

Notes on the sheet:
* Indicates a PWM-capable pin

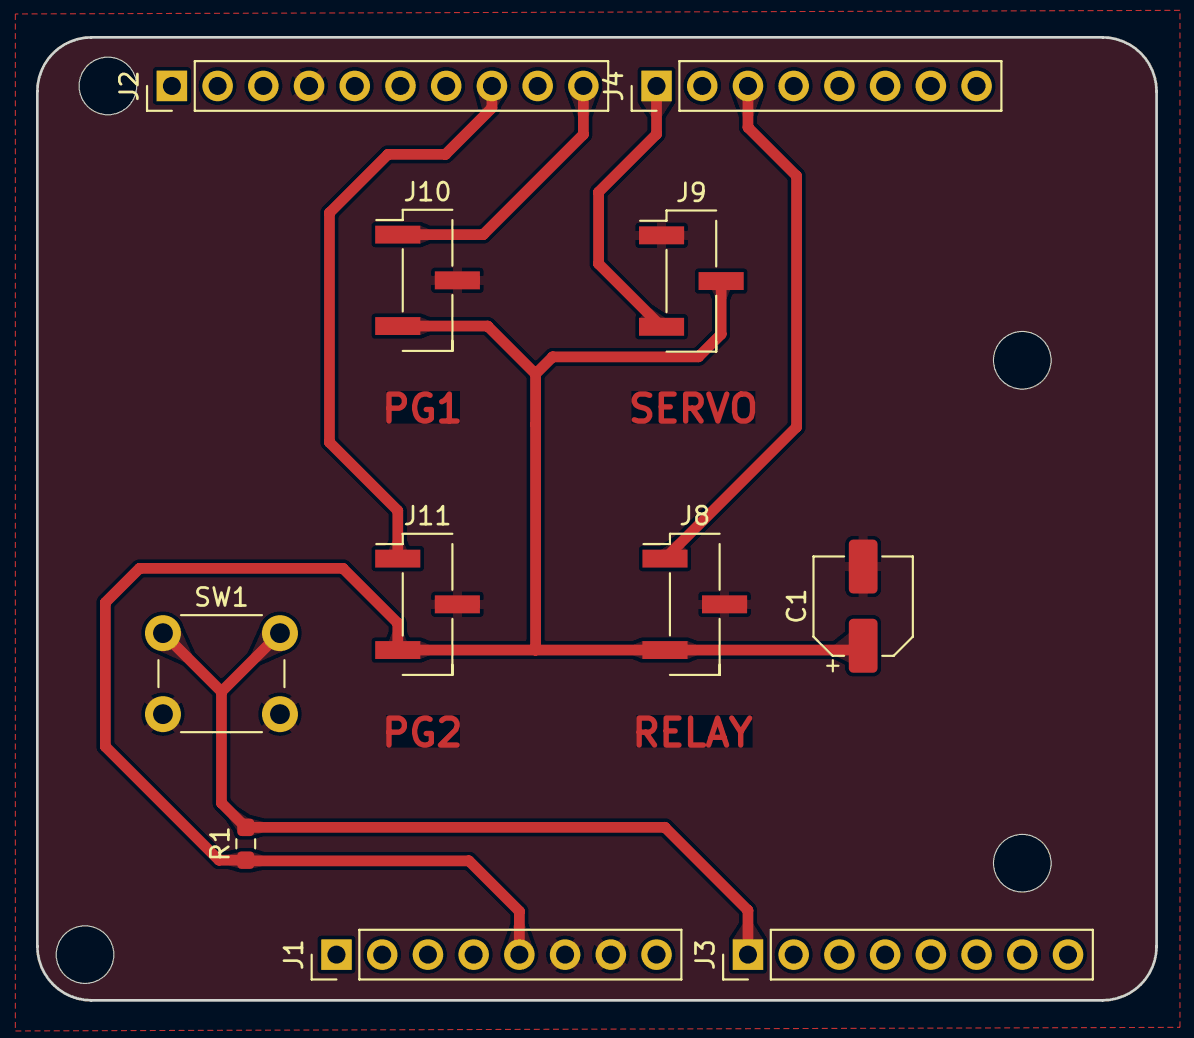
[picture p86: board Launcher_PCB.kicad_pcb from above]

Board: 2 copper layers, 62.2 x 53.5 mm, 15 parts (0 on the bottom side), 7 nets.

Other parts of the board:
MH1, MH2, MH3, MH4: MountingHole_3.2mm
