harrislab-brown/particle_launcher/(commit log)

2025-12-12 wiring and pinout tested
2026-03-05 designed an arduino hat to control particle launcher
    [Launcher_PCB.kicad_pcb, Launcher_PCB.kicad_sch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]
2026-03-10 basic code for milled PCB is working. Switched to arduino uno
2026-03-11 Changed camera delay and servo release angles based on what worked in our meeting on 3/11/26. This is the current code running on the arduino servo release
2026-03-11 Added MATLAB image processing scripts for tracking particle
    [notebook_3-11-26.csv, sphere_results.csv]
2026-03-23 calibrated servo and relay timing in arduino script, along with some other small changes. adjusted matlab sphere tracking to eliminate need to crop mirrored video. tested with sample mirrored video t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
2026-03-26 bug fixes. changed sphere tracking such that user need only perform the initial 3 calibration steps for the first video of a group of many taken from the exact same angle. also, user only needs to se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
    [main.cpp]
2026-04-15 added CAD folder
2026-04-15 added CAD folder take 2
2026-04-17 added fusion and solidworks CAD files, drawings, 3D print files, laser cut files for Version 6
    [91292A015_18-8 Stainless Steel Socket Head Screw.SLDPRT, 91292A115_18-8 Stainless Steel Socket Head Screw.SLDPRT, 94459A140_Heat-Set Inserts for Plastic.SLDPRT, 9657K42_Compression Spring.SLDPRT, PLV6_BAMBULABX1C.gcode.3mf, Particle 1.5mm.SLDPRT, Particle Launcher V6 adjust.stl, Particle Launcher V6 backstop.stl]
2026-04-17 added CAD files for previous versions and for various 3D-printed jigs
    [PL Flex Tube Hole Sizer.f3d, PL Flex Tube Hole Sizer.stl, PL Hypodermic Needle Cutting Jig.f3d, PL Hypodermic Needle Cutting Jig.stl, PL Hypodermic Needle Hole Sizer.f3d, PL Hypodermic Needle Hole Sizer.stl, PL Mirror Bracket.f3d, Particle Launcher V1.f3d]
2026-04-17 folder resturcture
    [91292A015_18-8 Stainless Steel Socket Head Screw.SLDPRT, 91292A115_18-8 Stainless Steel Socket Head Screw.SLDPRT, 94459A140_Heat-Set Inserts for Plastic.SLDPRT, 9657K42_Compression Spring.SLDPRT, PL Flex Tube Hole Sizer.stl, PL Hypodermic Needle Cutting Jig.stl, PL Hypodermic Needle Hole Sizer.stl, PLV6_BAMBULABX1C.gcode.3mf]
2026-05-19 added CAD files for 1mm launcher variant
    [Particle Launcher V6 1mm adjust.stl, Particle Launcher V6 1mm backstop.stl, Particle Launcher V6 1mm collar.stl, Particle Launcher V6 1mm end.stl, Particle Launcher V6 1mm funnel.stl, Particle Launcher V6 1mm latch.stl, Particle Launcher V6 1mm lid.stl, Particle Launcher V6 1mm magazine.stl]
2026-05-19 added 3mf print file for 1mm variant
    [PLV6_1.5mm_BAMBULABX1C.gcode.3mf, PLV6_1mm_BAMBULABX1C.gcode.3mf]
